r-pv/STM32H503CBT6/README.md

# STM32H503CBT6
ST development board based on the STM32H503CBT6 MCU. Compatible with Arduino.
