r-pv/STM32H503CBT6/STM32H503CBT6.pinout.png

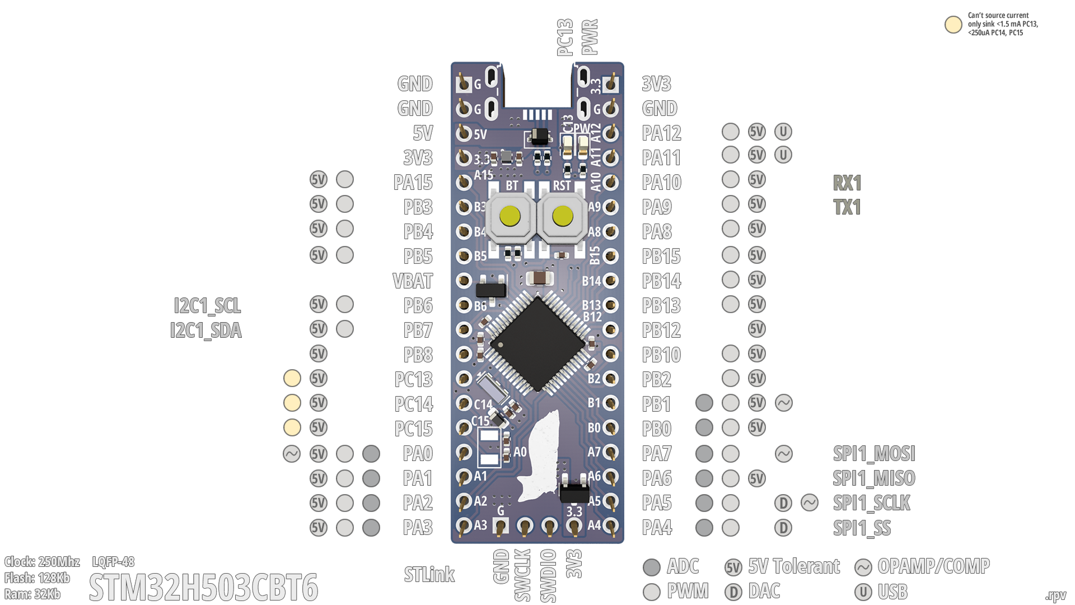
STM32H503CBT6.pinout.png
