r-pv/STM32H503CBT6/STM32H503CBT6/STM32H503CBT6.pdf

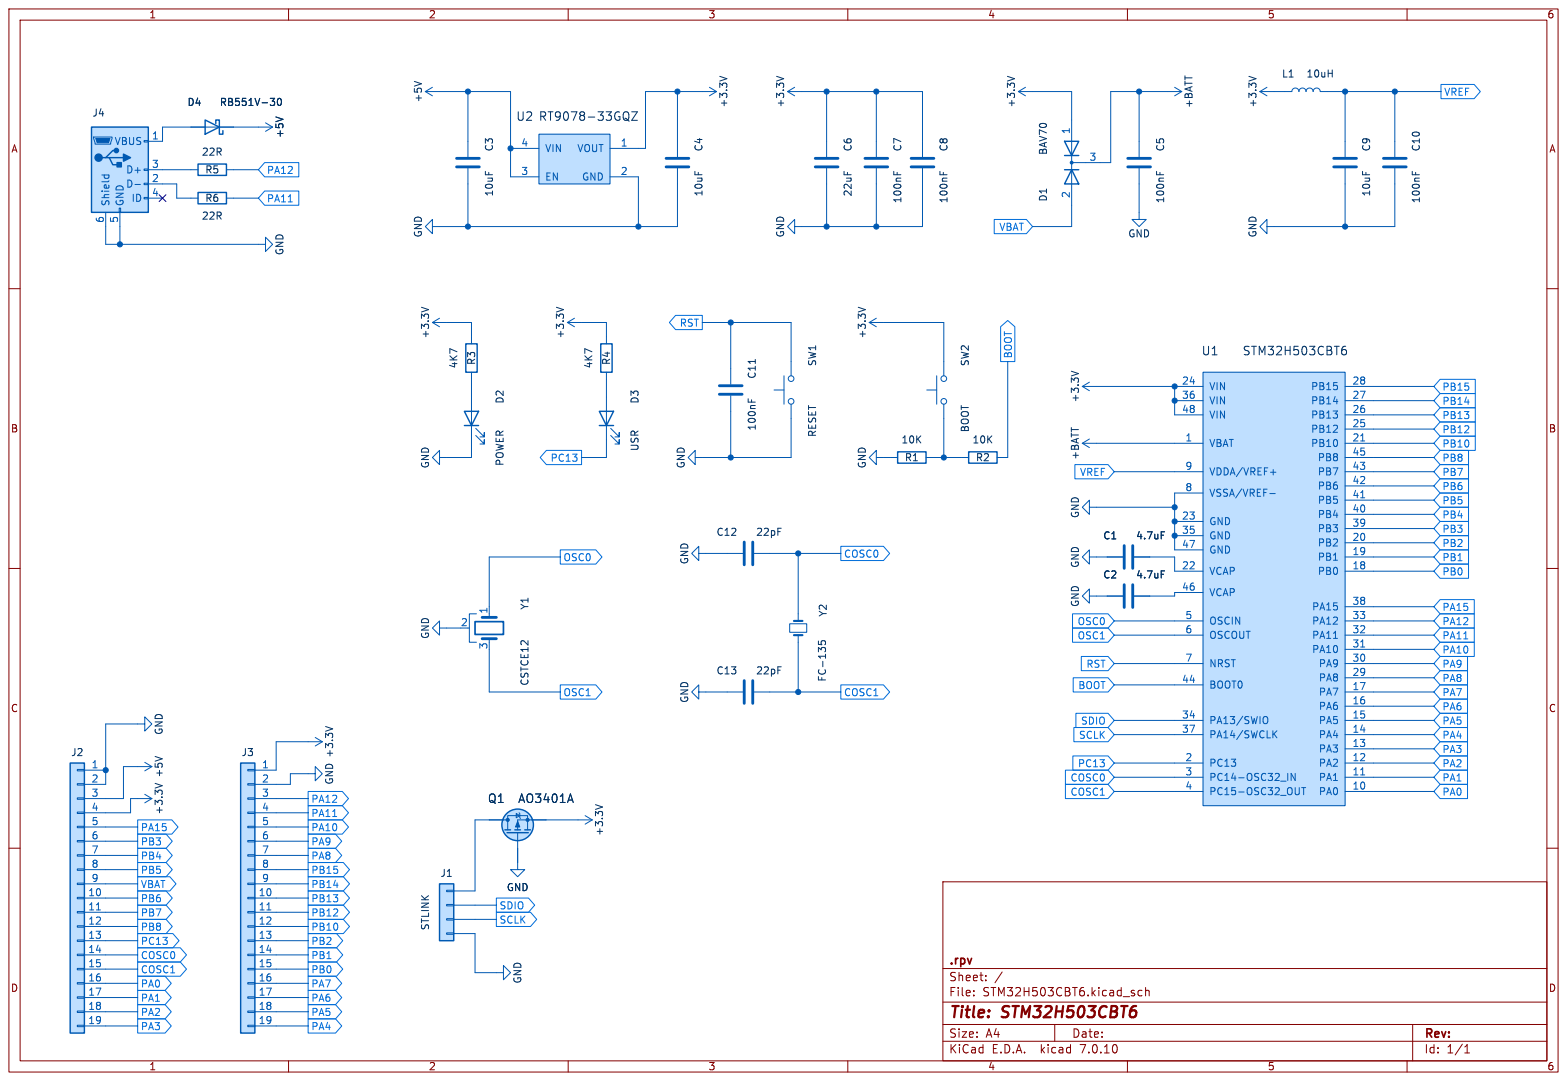
[picture p2: page 1]
