r-pv/STM32H503CBT6/STM32H503CBT6/STM32H503CBT6.kicad_pcb

## KiCad design STM32H503CBT6/STM32H503CBT6.kicad_pcb (2024-02-01)

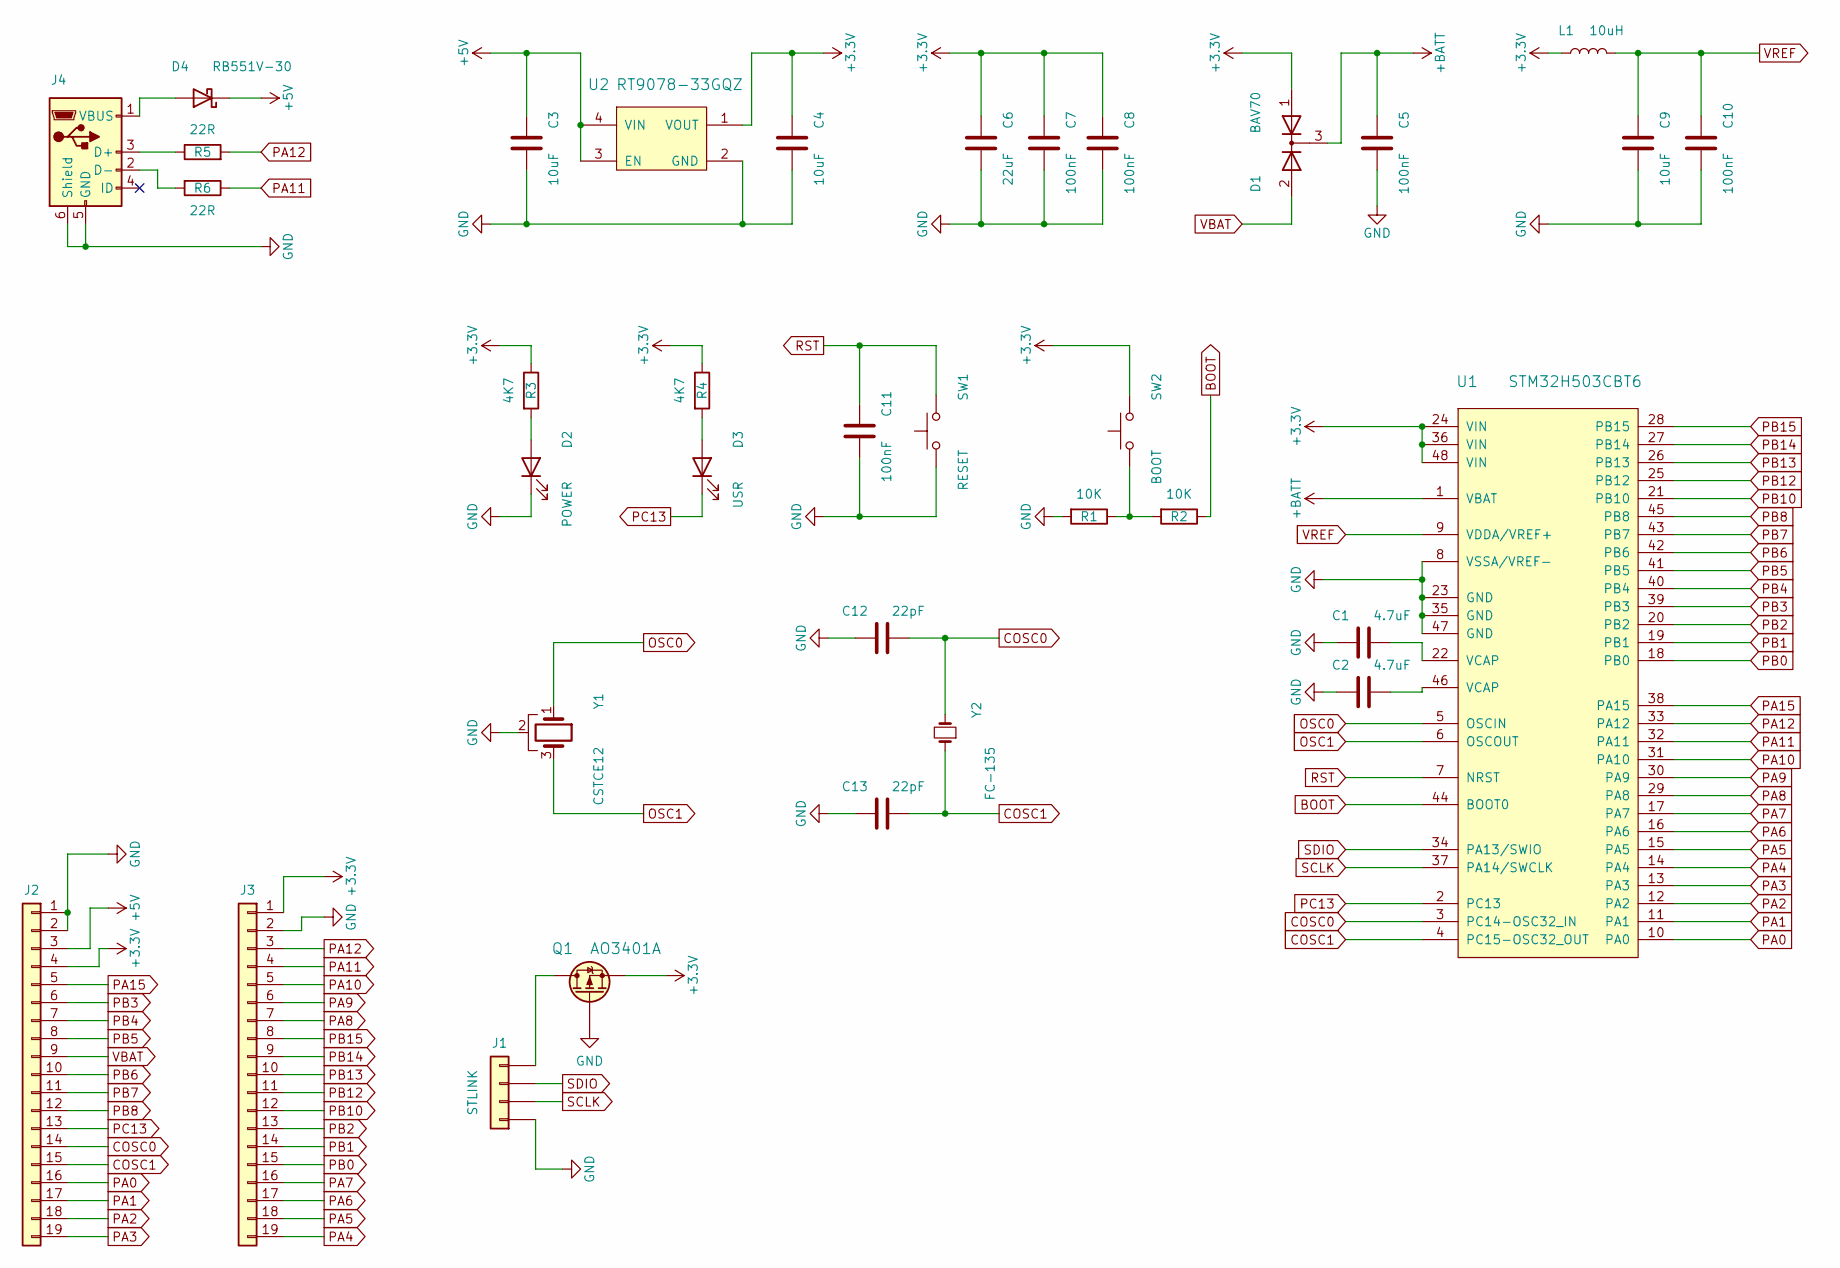
[picture p3: schematic STM32H503CBT6.kicad_sch]

Parts:
C1, C2: 4.7uF; C_0402_1005Metric
C3, C4, C9: 10uF; C_0402_1005Metric
C5, C7, C8, C10, C11: 100nF; C_0402_1005Metric
C6: 22uF; C_0805_2012Metric
C12, C13: 22pF; C_0402_1005Metric
D1: BAV70; SOT-23
D2: POWER; LED_0603_1608Metric
D3: USR; LED_0603_1608Metric
D4: RB551V-30; D_SOD-323
J1: STLINK; PinSocket_1x04_P2.54mm_Vertical
J2, J3: PinSocket_1x19_P2.54mm_Vertical
J4: connector_USB_Micro-B2
L1: 10uH; L_0603_1608Metric
Q1: AO3401A; SOT-23
R1, R2: 10K; R_0402_1005Metric
R3, R4: 4K7; R_0402_1005Metric
R5, R6: 22R; R_0402_1005Metric
SW1: RESET; Switch_SMD_5.2x6.4_reset
SW2: BOOT; Switch_SMD_5.2x6.4_reset
U1: STM32H503CBT6; LQFP-48_7x7mm_P0.5mm
U2: RT9078-33GQZ; XDFN4_1x1mm_0.65P
Y1: CSTCE12; Crystal_CSTCE_3pin_3.2x1.3
Y2: FC-135; Crystal_FC-135

Connections:
+3.3V: C4.1, C6.1, C7.1, C8.1, D1.1 (A), J2.4, J3.1, L1.1, Q1.2 (S), R3.1, R4.1, SW2.2, U1.24 (VIN), U1.36 (VIN), U1.48 (VIN), U2.1 (VOUT)
+5V: C3.1, D4.1 (K), J2.3, U2.3 (EN), U2.4 (VIN)
+BATT: C5.1, D1.3 (K), U1.1 (VBAT)
BOOT: R2.1, U1.44 (BOOT0)
COSC0: C12.2, J2.14, U1.3 (PC14-OSC32_IN), Y2.2
COSC1: C13.2, J2.15, U1.4 (PC15-OSC32_OUT), Y2.1
GND: C1.1, C2.1, C3.2, C4.2, C5.2, C6.2, C7.2, C8.2, C9.2, C10.2, C11.2, C12.1, C13.1, D2.1 (K), J1.1, J2.1, J2.2, J3.2, J4.5 (GND), J4.6 (Shield), Q1.1 (G), R1.2, SW1.1, U1.8 (VSSA/VREF-), U1.23 (GND), U1.35 (GND), U1.47 (GND), U2.2 (GND), Y1.2
unnamed: C1.2, U1.22 (VCAP)
unnamed: C2.2, U1.46 (VCAP)
unnamed: D2.2 (A), R3.2
unnamed: D3.2 (A), R4.2
unnamed: D4.2 (A), J4.1 (VBUS)
unnamed: J1.4, Q1.3 (D)
unnamed: J4.3 (D+), R5.1
unnamed: J4.2 (D-), R6.2
unnamed: R1.1, R2.2, SW2.1
OSC0: U1.5 (OSCIN), Y1.1
OSC1: U1.6 (OSCOUT), Y1.3
PA0: J2.16, U1.10 (PA0)
PA1: J2.17, U1.11 (PA1)
PA2: J2.18, U1.12 (PA2)
PA3: J2.19, U1.13 (PA3)
PA4: J3.19, U1.14 (PA4)
PA5: J3.18, U1.15 (PA5)
PA6: J3.17, U1.16 (PA6)
PA7: J3.16, U1.17 (PA7)
PA8: J3.7, U1.29 (PA8)
PA9: J3.6, U1.30 (PA9)
PA10: J3.5, U1.31 (PA10)
PA11: J3.4, R6.1, U1.32 (PA11)
PA12: J3.3, R5.2, U1.33 (PA12)
PA15: J2.5, U1.38 (PA15)
PB0: J3.15, U1.18 (PB0)
PB1: J3.14, U1.19 (PB1)
PB2: J3.13, U1.20 (PB2)
PB3: J2.6, U1.39 (PB3)
PB4: J2.7, U1.40 (PB4)
PB5: J2.8, U1.41 (PB5)
PB6: J2.10, U1.42 (PB6)
PB7: J2.11, U1.43 (PB7)
PB8: J2.12, U1.45 (PB8)
PB10: J3.12, U1.21 (PB10)
PB12: J3.11, U1.25 (PB12)
PB13: J3.10, U1.26 (PB13)
PB14: J3.9, U1.27 (PB14)
PB15: J3.8, U1.28 (PB15)
PC13: D3.1 (K), J2.13, U1.2 (PC13)
RST: C11.1, SW1.2, U1.7 (NRST)
SCLK: J1.2, U1.37 (PA14/SWCLK)
SDIO: J1.3, U1.34 (PA13/SWIO)
VBAT: D1.2 (A), J2.9
VREF: C9.1, C10.1, L1.2, U1.9 (VDDA/VREF+)

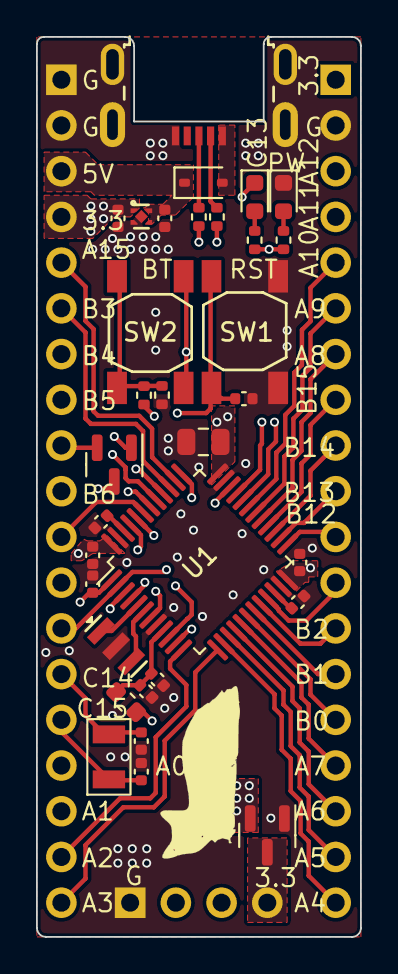
[picture p4: board STM32H503CBT6.kicad_pcb from above]

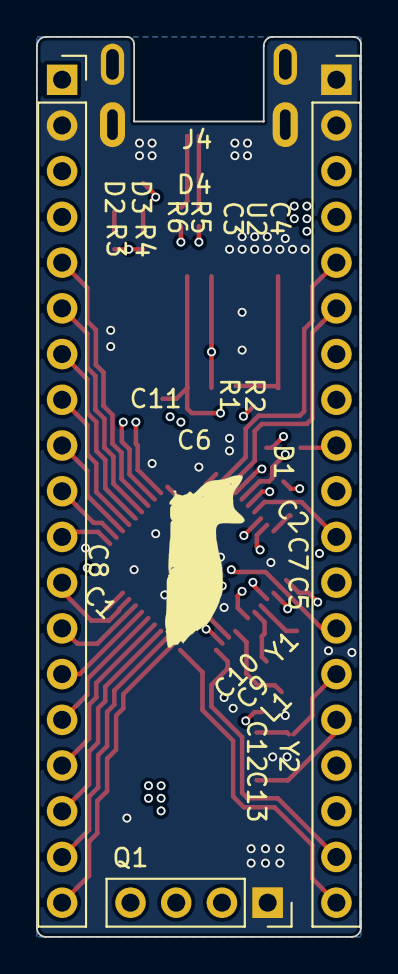
[picture p5: board STM32H503CBT6.kicad_pcb from below]

Board: 4 copper layers, 18.0 x 50.0 mm, 35 parts (3 on the bottom side), 52 nets.
