r-pv/STM32H503CBT6/(commit log)

2024-02-01 KiCAD Files.
    Board Files.
    [BOM.csv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]
2024-02-01 Arduino Variant
    Pending...
